ZeEzTw/HeatMap/PCB/PCB_ESP32/PCH_ESP32.step

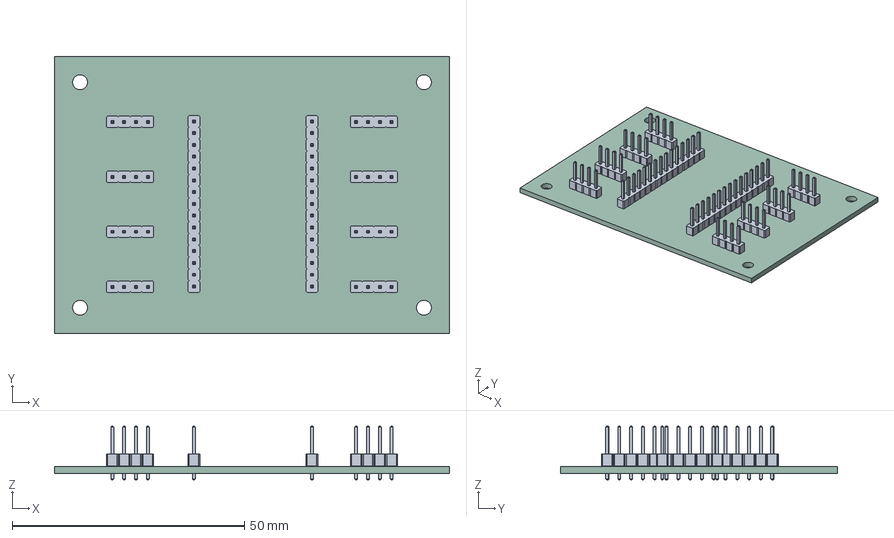
[picture p8: CAD file, 2025-12-22]
PCB/PCB_ESP32/PCH_ESP32.step
85.0 x 59.5 x 11.5 mm
PinHeader_1x04_P2.54mm_Vertical x 8
PinHeader_1x15_P2.54mm_Vertical x 2
PCH_ESP32_PCB
