ZeEzTw/HeatMap/(list of files, cad)

Other CAD files:
cutie.ipt
