ZeEzTw/HeatMap/PCB/PCB/PCH_ESP32.kicad_pcb

## KiCad design PCB/PCB/PCH_ESP32.kicad_pcb (2025-12-22)

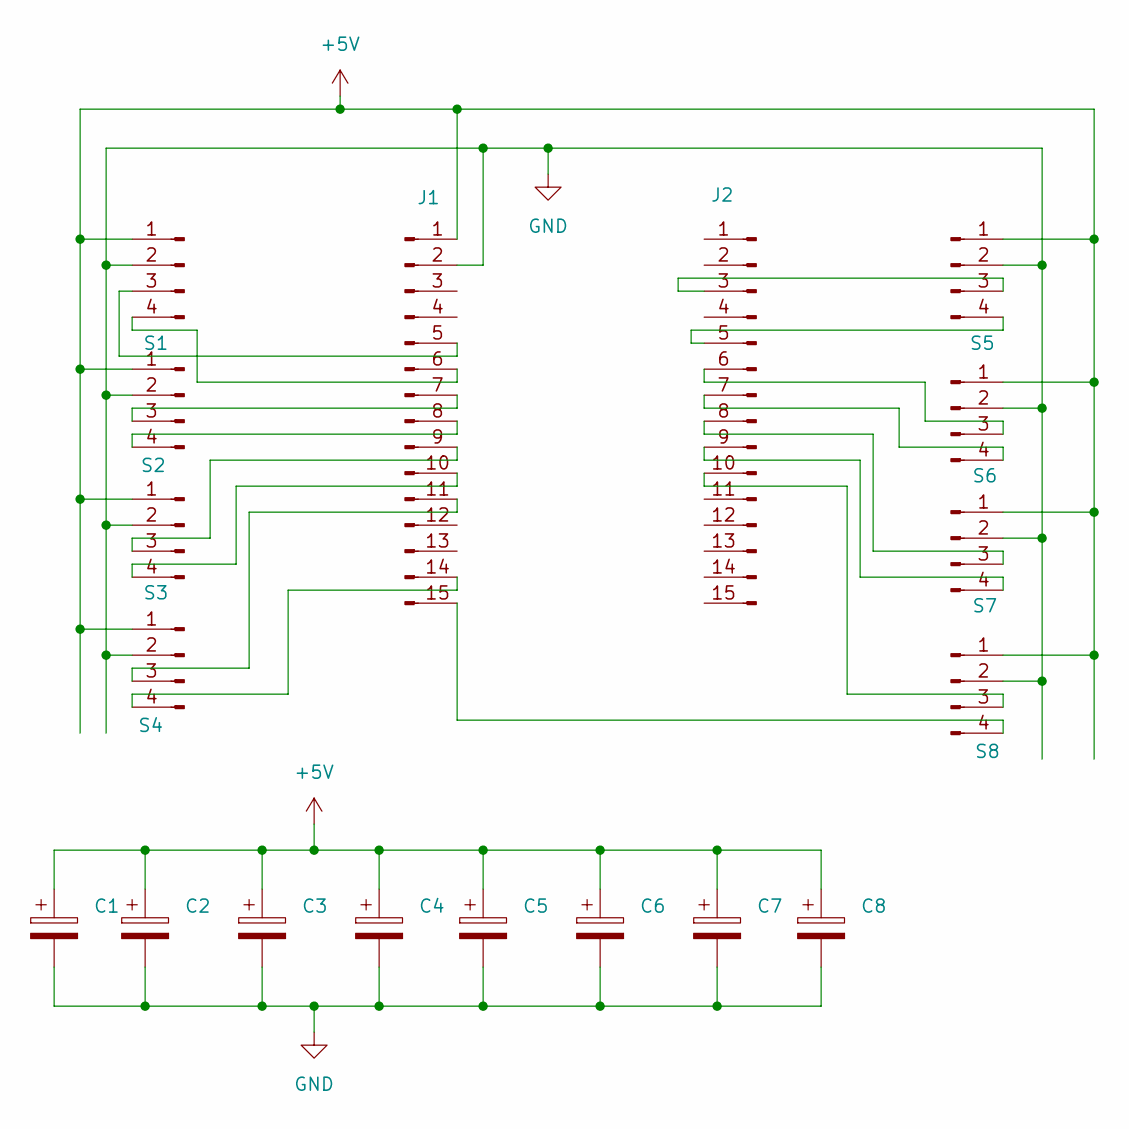
[picture p9: schematic PCH_ESP32.kicad_sch]

Parts:
C1, C2, C3, C4, C5, C6, C7, C8: C_Polarized; C_0805_2012Metric
J1, J2: Conn_01x16_Pin; PinHeader_1x15_P2.54mm_Vertical
S1, S2, S3, S4, S5, S6, S7, S8: Conn_01x04_Pin; PinHeader_1x04_P2.54mm_Vertical

Connections:
+5V: C1.1, C2.1, C3.1, C4.1, C5.1, C6.1, C7.1, C8.1, J1.1, S1.1, S2.1, S3.1, S4.1, S5.1, S6.1, S7.1, S8.1
GND: C1.2, C2.2, C3.2, C4.2, C5.2, C6.2, C7.2, C8.2, J1.2, S1.2, S2.2, S3.2, S4.2, S5.2, S6.2, S7.2, S8.2
unnamed: J1.5, S1.3
unnamed: J1.6, S1.4
unnamed: J1.7, S2.3
unnamed: J1.8, S2.4
unnamed: J1.9, S3.3
unnamed: J1.10, S3.4
unnamed: J1.11, S4.3
unnamed: J1.14, S4.4
unnamed: J1.15, S8.4
unnamed: J2.5, S5.4
unnamed: J2.7, S6.4
unnamed: J2.3, S5.3
unnamed: J2.8, S7.3
unnamed: J2.10, S8.3
unnamed: J2.9, S7.4
unnamed: J2.6, S6.3

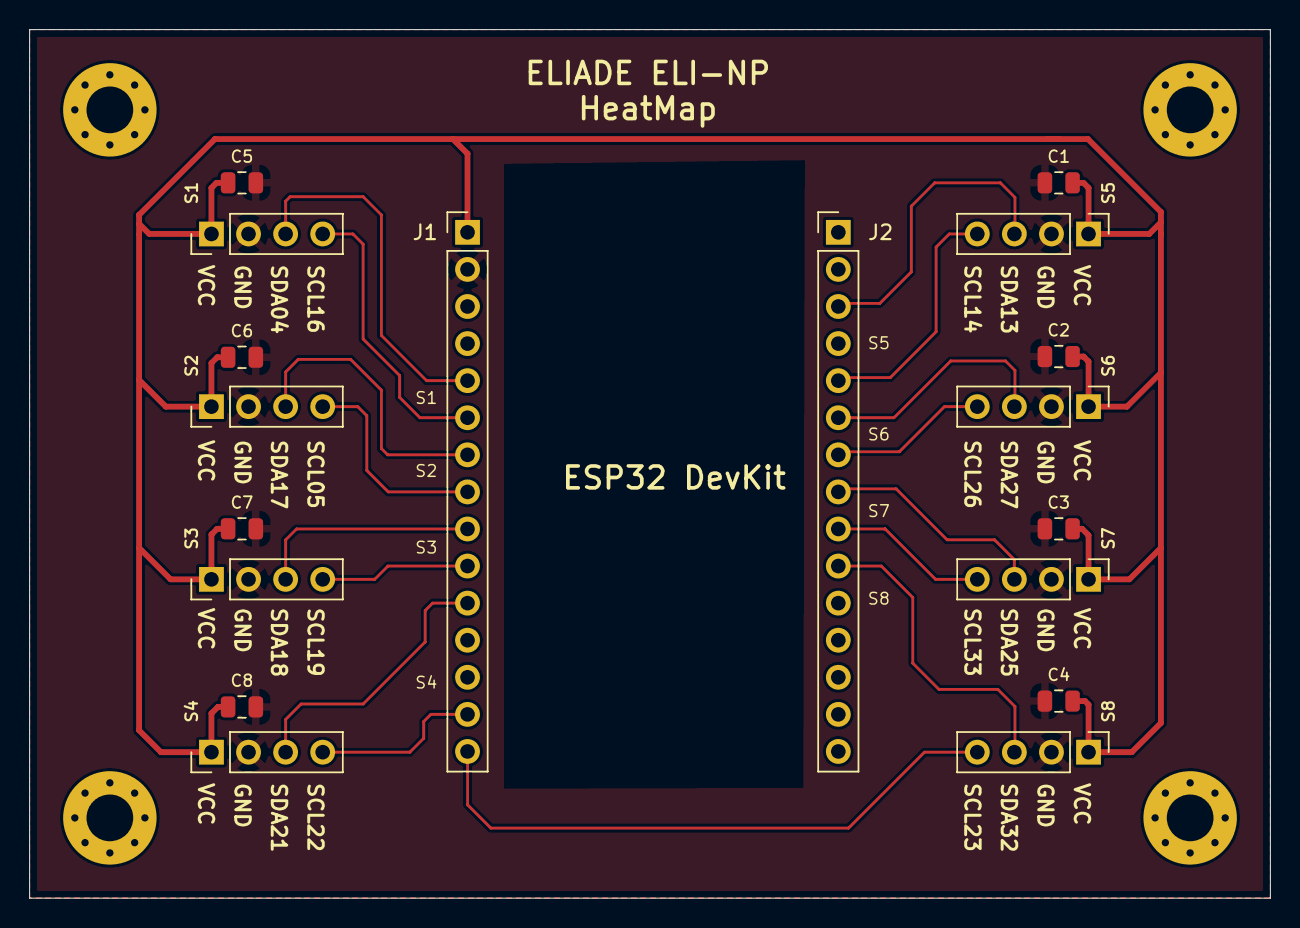
[picture p10: board PCB/PCB/PCH_ESP32.kicad_pcb from above]

Board: 2 copper layers, 85.0 x 59.5 mm, 18 parts (0 on the bottom side), 18 nets.
