ZeEzTw/HeatMap/PCB (Quicc)/PCB_ESP32/PCH_ESP32.kicad_pcb

## KiCad design PCB (Quicc)/PCB_ESP32/PCH_ESP32.kicad_pcb (2025-09-17, an earlier design)

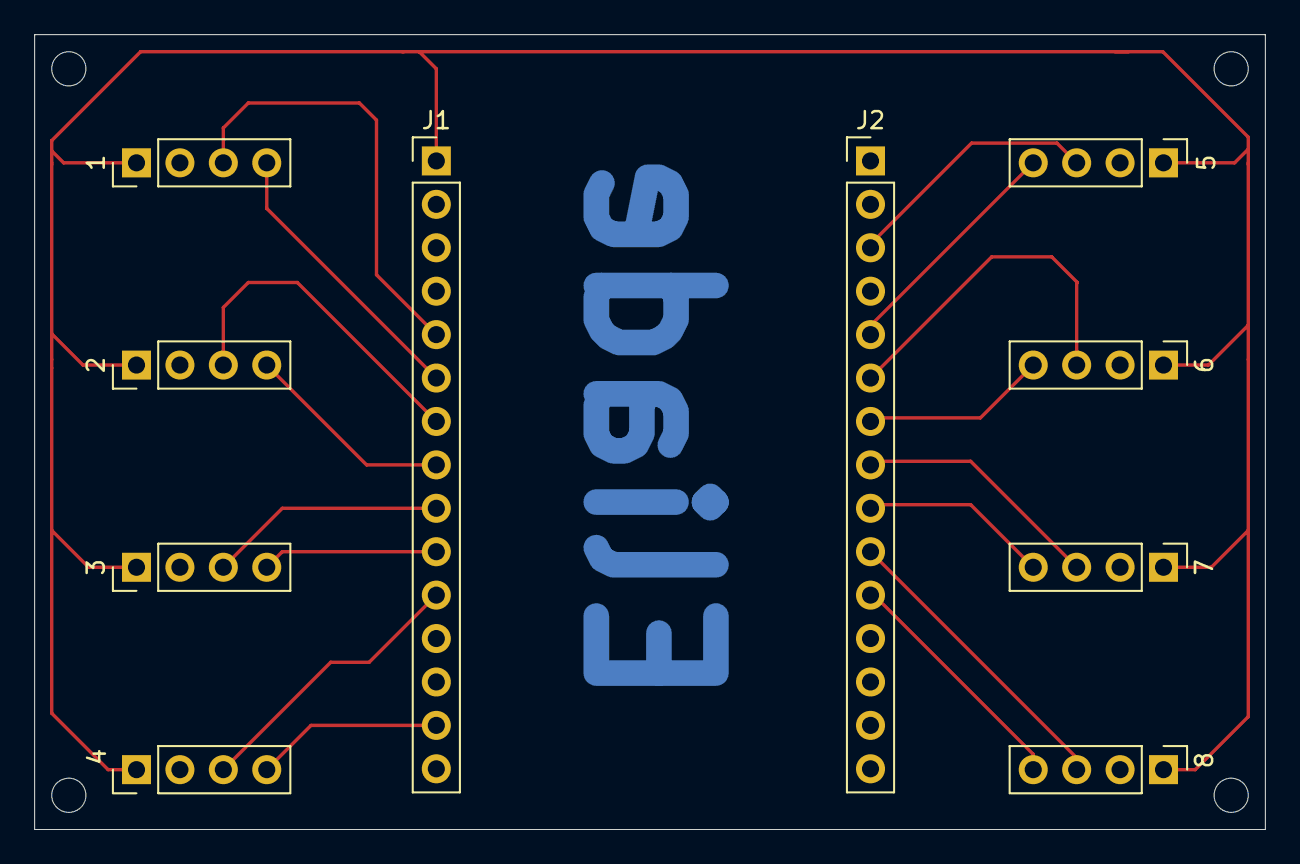
[picture p11: board PCB (Quicc)/PCB_ESP32/PCH_ESP32.kicad_pcb from above]

Board: 2 copper layers, 72.0 x 46.5 mm, 10 parts (0 on the bottom side), 18 nets.

Parts:
1, 2, 3, 4, 5, 6, 7, 8: Conn_01x04_Pin; PinHeader_1x04_P2.54mm_Vertical
J1, J2: Conn_01x16_Pin; PinHeader_1x15_P2.54mm_Vertical

Connections:
unnamed: 1.1, 2.1, 3.1, 4.1, 5.1, 6.1, 7.1, 8.1, J1.1
unnamed: 1.2, 2.2, 3.2, 4.2, 5.2, 6.2, 7.2, 8.2, J1.2
unnamed: 1.3, J1.5
unnamed: 1.4, J1.6
unnamed: 2.3, J1.7
unnamed: 2.4, J1.8
unnamed: 3.3, J1.9
unnamed: 3.4, J1.10
unnamed: 4.3, J1.11
unnamed: 4.4, J1.14
unnamed: 5.3, J2.3
unnamed: 5.4, J2.5
unnamed: 6.3, J2.6
unnamed: 6.4, J2.7
unnamed: 7.3, J2.8
unnamed: 7.4, J2.9
unnamed: 8.3, J2.10
unnamed: 8.4, J2.11
