ZeEzTw/HeatMap/PCB (Quicc)/pcbQuicc/pcbQuicc.kicad_pcb

## KiCad design PCB (Quicc)/pcbQuicc/pcbQuicc.kicad_pcb (2025-11-14)

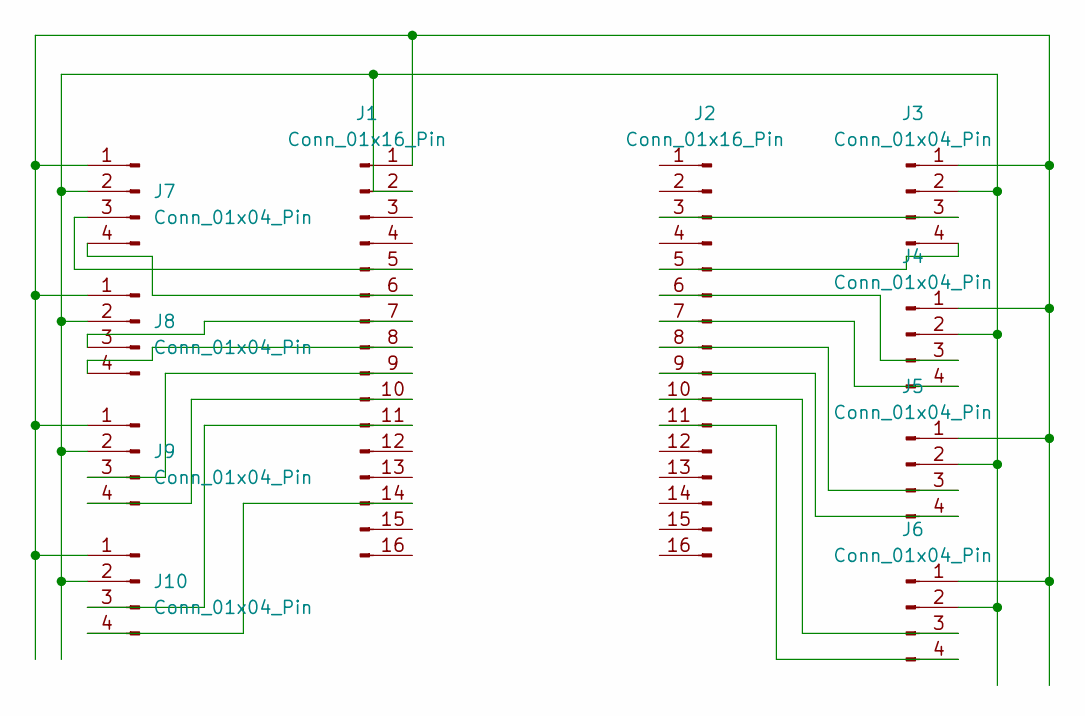
[picture p12: schematic pcbQuicc.kicad_sch]

Parts:
J1, J2: Conn_01x16_Pin; PinHeader_1x15_P2.54mm_Vertical
J3, J4, J5, J6, J7, J8, J9: Conn_01x04_Pin; JST_SH_BM04B-SRSS-TB_1x04-1MP_P1.00mm_Vertical
J10: Conn_01x04_Pin; PinHeader_1x04_P2.54mm_Vertical

Connections:
unnamed: J1.2 (GND), J3.2, J4.2, J5.2, J6.2, J7.2 (GND), J8.2 (GND), J9.2, J10.2
unnamed: J1.1, J3.1, J4.1, J5.1, J6.1, J7.1, J8.1, J9.1, J10.1
unnamed: J1.5, J7.3
unnamed: J1.6, J7.4
unnamed: J1.7, J8.3
unnamed: J1.8, J8.4
unnamed: J1.9, J9.3
unnamed: J1.10, J9.4
unnamed: J1.11, J10.3
unnamed: J1.14, J10.4
unnamed: J2.3, J3.3
unnamed: J2.5, J3.4
unnamed: J2.6, J4.3
unnamed: J2.7, J4.4
unnamed: J2.8, J5.3
unnamed: J2.9, J5.4
unnamed: J2.10, J6.3
unnamed: J2.11, J6.4

Board: 2 copper layers, 10 parts (0 on the bottom side), 18 nets, no tracks yet.
