ZeEzTw/HeatMap/(commit log)

2025-06-23 Initial ESP32 + AHT21 integration: data read, Wi-Fi, and InfluxDB write
    - Received ESP32 board with 2 AHT21 sensors
    - Configured device for Linux detection
    - Wrote prototype code to read and print temperature/humidity values
    - Verified sensor data accuracy
    - Added Wi-Fi connection and live InfluxDB cloud integration
    Next: -test 2 sensors with Qwiic conncetion
    -add config via file
    -design project flow (pdf)
2025-06-24 Added JSON-based configuration system for ESP32 device Device now reads key parameters (Wi-Fi, InfluxDB, ID, delay) from a JSON file stored with the firmware Implemented NTP-based time synchronizatio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
2025-07-04 added v2 of the code, where I tried to bitBang pins to use them as I2C, i managed to call the sensor and recive some data, but somthing its wrong
2025-07-04 Added support for all sensors, I siwtch the declaration of the TwoWire and initialize it with each bin pair, and then kill it, and do this in a loop, after taking the data
2025-07-17 am adaugat error si o suma pentru date mai bune
    [Error.h, esp32Code3.ino]
2025-07-21 am adaugat planul de achizitie si o reprezentare a proiectului + cateva modificari la cod cu medie
2025-08-19 added a new version of the code, with the v1 of the pcb
    [PCB_ESP32.kicad_pcb, PCB_ESP32.kicad_sch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]
2025-08-28 added the stl file for 3d printing test
2025-09-17 added PCB schematic
    [PCB_ESP32.kicad_pcb, PCB_ESP32.kicad_sch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]
2025-09-17 changed the delay for senzors reding + more info to telegram messages, to show which senzor is failing
    [ConfigData.h, Error.cpp, Error.h, InfluxDB.cpp, InfluxDB.h, Telegram.cpp, esp32Code3.ino]
2025-10-14 Tried using SoftWire without success. Created a new library, BitBandAht21Eli, that simulates I2C protocol on any GPIO, based on a specific class. Successfully initialized the sensor and read data usi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
2025-11-14 created bigbang for i2c conexion libraty
    [PCH_ESP32-B_Cu.gbr, PCH_ESP32-B_Mask.gbr, PCH_ESP32-B_Paste.gbr, PCH_ESP32-B_Silkscreen.gbr, PCH_ESP32-Edge_Cuts.gbr, PCH_ESP32-F_Cu.gbr, PCH_ESP32-F_Mask.gbr, PCH_ESP32-F_Paste.gbr]
2025-11-20 removed Adafruit_AHTx0.h and Wire.h dependency
2025-11-20 removed Senzor.h and Senzor.cpp, ale the variables is now in Error.h
    [Error.cpp, Error.h]
2025-11-27 implemeneted InfluxDBLocal writting, for the final version of the code extra, removed the time syncornization, to avoid influxDB error for 2 eso writting in the same time
    [ConfigData.h, InfluxDB.cpp, InfluxDB.h, esp32Code3.ino]
2025-12-09 new pcb model
    [PCH_ESP32.kicad_pcb]
2025-12-22 added the new pcb design, and fixel the code to write real values
    [PCH_ESP32-B_Cu.gbr, PCH_ESP32-B_Mask.gbr, PCH_ESP32-B_Paste.gbr, PCH_ESP32-B_Silkscreen.gbr, PCH_ESP32-Edge_Cuts.gbr, PCH_ESP32-F_Cu.gbr, PCH_ESP32-F_Mask.gbr, PCH_ESP32-F_Paste.gbr]
2026-03-01 Box design v1 ipt
    The ipb for the box that will hold the pcb and the esp32
    [cutie.ipt]
2026-05-10 Update sda/scl swap if wiring is wrong placed
    [BitBangAHT21ELI.h, BitBangAht21ELI.cpp, ConfigData.h, InfluxDB.cpp, esp32Code3.ino]
2026-05-16 code update to expalin each reset error better
    [ConfigData.h, Error.cpp, Error.h, esp32Code3.ino]
